uci-f1tenth/Power-board/Tuan Circuit Design LM5155/PCB Design LM5155 Boost Converter.kicad_pcb

## KiCad design Tuan Circuit Design LM5155/PCB Design LM5155 Boost Converter.kicad_pcb (2026-05-14)

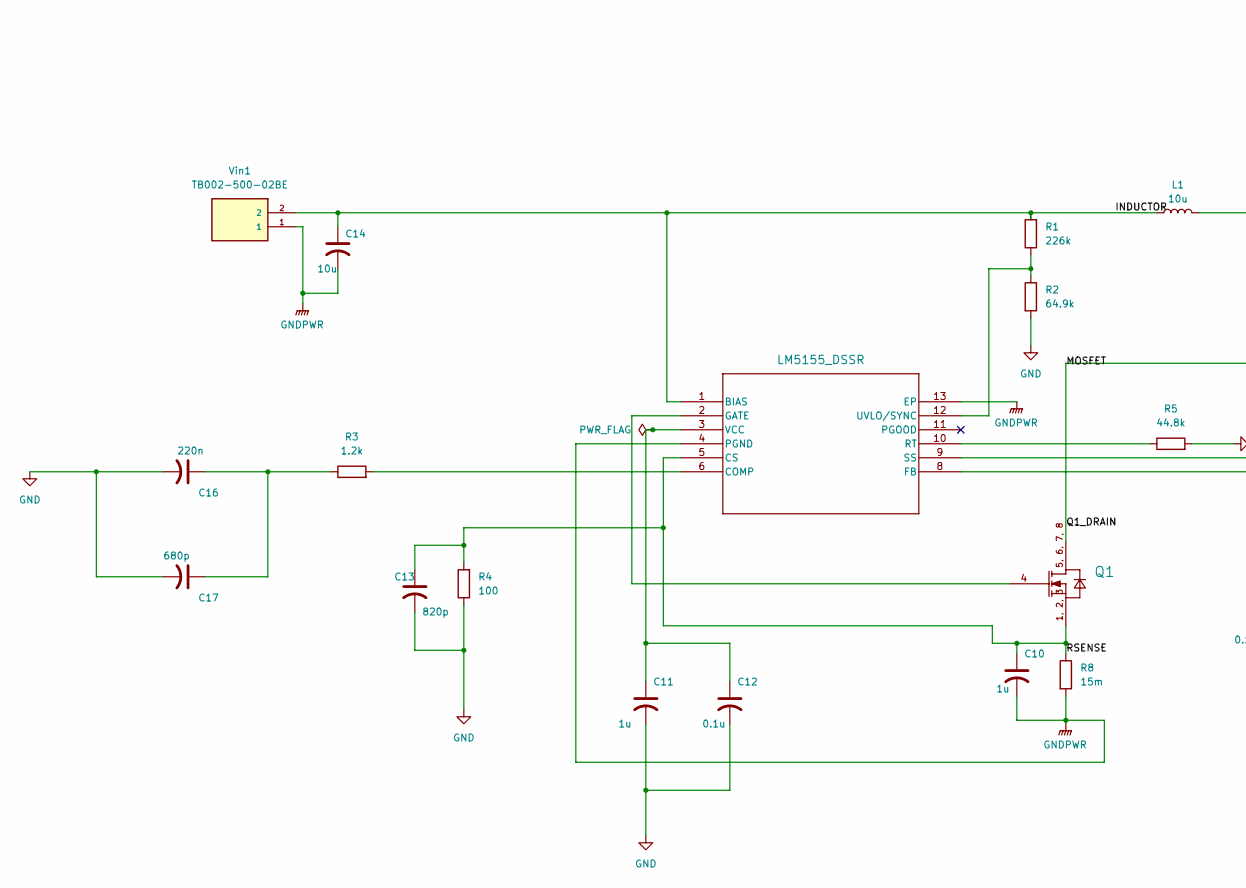
[picture p1: schematic PCB Design LM5155 Boost Converter.kicad_sch, Ai SpiderBot Power System, part in row 1, column 1]

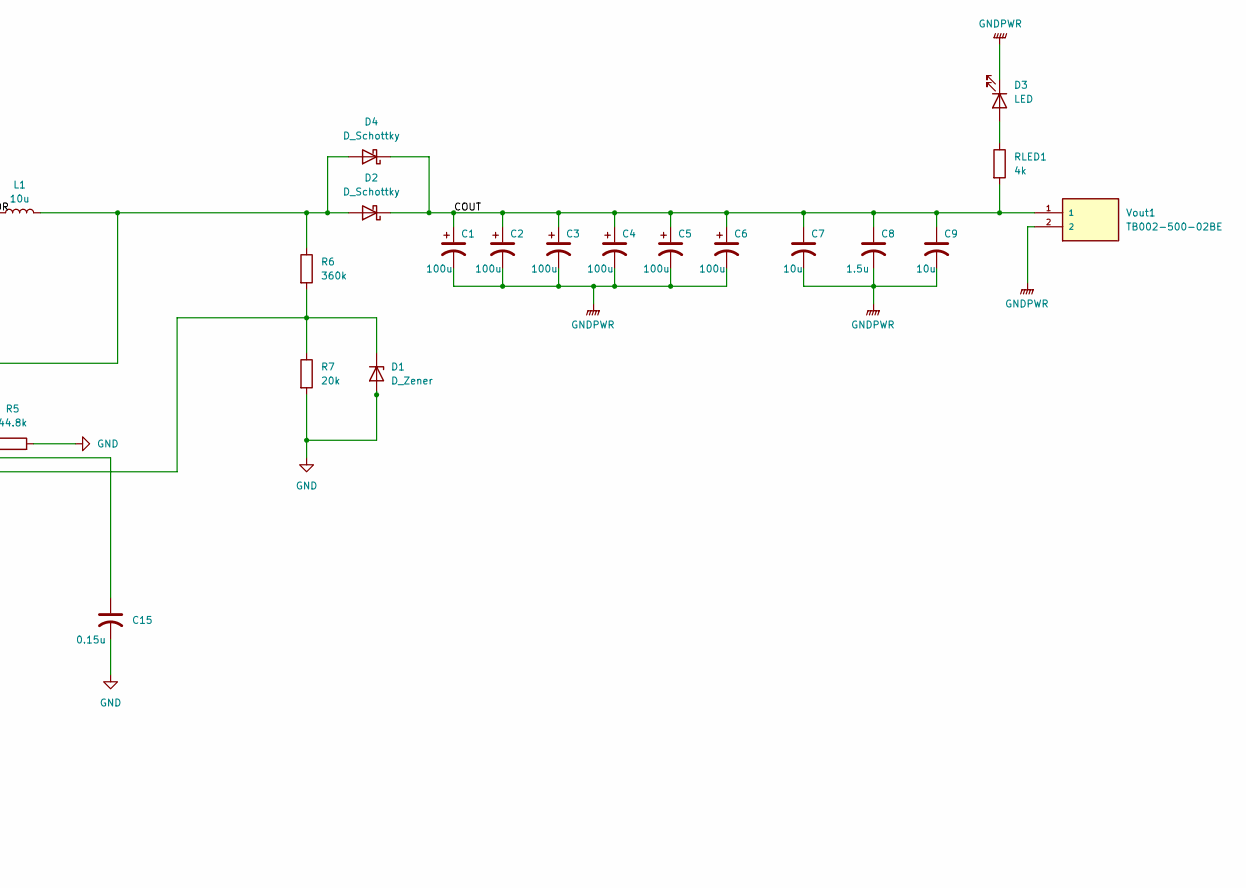
[picture p2: schematic PCB Design LM5155 Boost Converter.kicad_sch, Ai SpiderBot Power System, part in row 1, column 2]

Parts:
C1, C2, C3, C4, C5, C6: 100u; CP_Elec_6.3x5.8
C7, C9, C14: 10u; C_0603_1608Metric
C8: 1.5u; C_0603_1608Metric
C10, C11: 1u; C_0402_1005Metric
C12: 0.1u; C_0603_1608Metric
C13: 820p; C_0402_1005Metric_Pad0.74x0.62mm_HandSolder
C15: 0.15u; C_0603_1608Metric
C16: 220n; C_0603_1608Metric
C17: 680p; C_0603_1608Metric
D1: D_Zener; D_SOD-123
D2, D4: D_Schottky; TO-252-2_TabPin1
D3: LED; LED_0805_2012Metric_Pad1.15x1.40mm_HandSolder
L1: 10u; L_Vishay_IHLP-5050
Q1: BSC035N04LS G; INF-PG-TDSON-8; ManufacturerPartNumber BSC035N04LS G
R1: 226k; R_0603_1608Metric_Pad0.98x0.95mm_HandSolder
R2: 64.9k; R_0603_1608Metric_Pad0.98x0.95mm_HandSolder
R3: 1.2k; R_0603_1608Metric
R4: 100; R_0603_1608Metric_Pad0.98x0.95mm_HandSolder
R5: 44.8k; R_0603_1608Metric_Pad0.98x0.95mm_HandSolder
R6: 360k; R_0402_1005Metric_Pad0.72x0.64mm_HandSolder
R7: 20k; R_0402_1005Metric_Pad0.72x0.64mm_HandSolder
R8: 15m; R_2512_6332Metric_Pad1.40x3.35mm_HandSolder
RLED1: 4k; R_0402_1005Metric_Pad0.72x0.64mm_HandSolder
U1: LM5155_DSSR; WSON_551DSSR_TEX
Vin1: TB002-500-02BE; CUI_TB002-500-02BE
Vout1: TB002-500-02BE; CUI_TB002-500-02BE

Connections:
/COUT: C1.1, C2.1, C3.1, C4.1, C5.1, C6.1, C7.1, C8.1, C9.1, D2.1 (K), D4.1 (K), RLED1.2, Vout1.1
/INDUCTOR: C14.1, L1.1, R1.2, U1.1 (BIAS), Vin1.2
/MOSFET: D2.2 (A), D4.2 (A), L1.2, Q1.5 (DRAIN), Q1.6 (DRAIN), Q1.7 (DRAIN), Q1.8 (DRAIN), R6.1
/RSENSE: C10.1, C13.1, Q1.1 (SOURCE), Q1.2 (SOURCE), Q1.3 (SOURCE), R4.2, R8.1, U1.5 (CS)
GND: C11.2, C12.2, C13.2, C15.2, C16.2, C17.2, D1.2 (A), R2.2, R4.1, R5.2, R7.2
GNDPWR: C1.2, C2.2, C3.2, C4.2, C5.2, C6.2, C7.2, C8.2, C9.2, C10.2, C14.2, D3.1 (K), R8.2, U1.4 (PGND), U1.13 (EP), Vin1.1, Vout1.2
unnamed: C16.1, C17.1, R3.1
unnamed: D1.1 (K), R6.2, R7.1, U1.8 (FB)
unnamed: D3.2 (A), RLED1.1
unnamed: Q1.4 (GATE), U1.2 (GATE)
unnamed: R3.2, U1.6 (COMP)
unnamed: R5.1, U1.10 (RT)
unnamed: C15.1, U1.9 (SS)
unnamed: R1.1, R2.1, U1.12 (UVLO/SYNC)
unnamed: C11.1, C12.1, U1.3 (VCC)

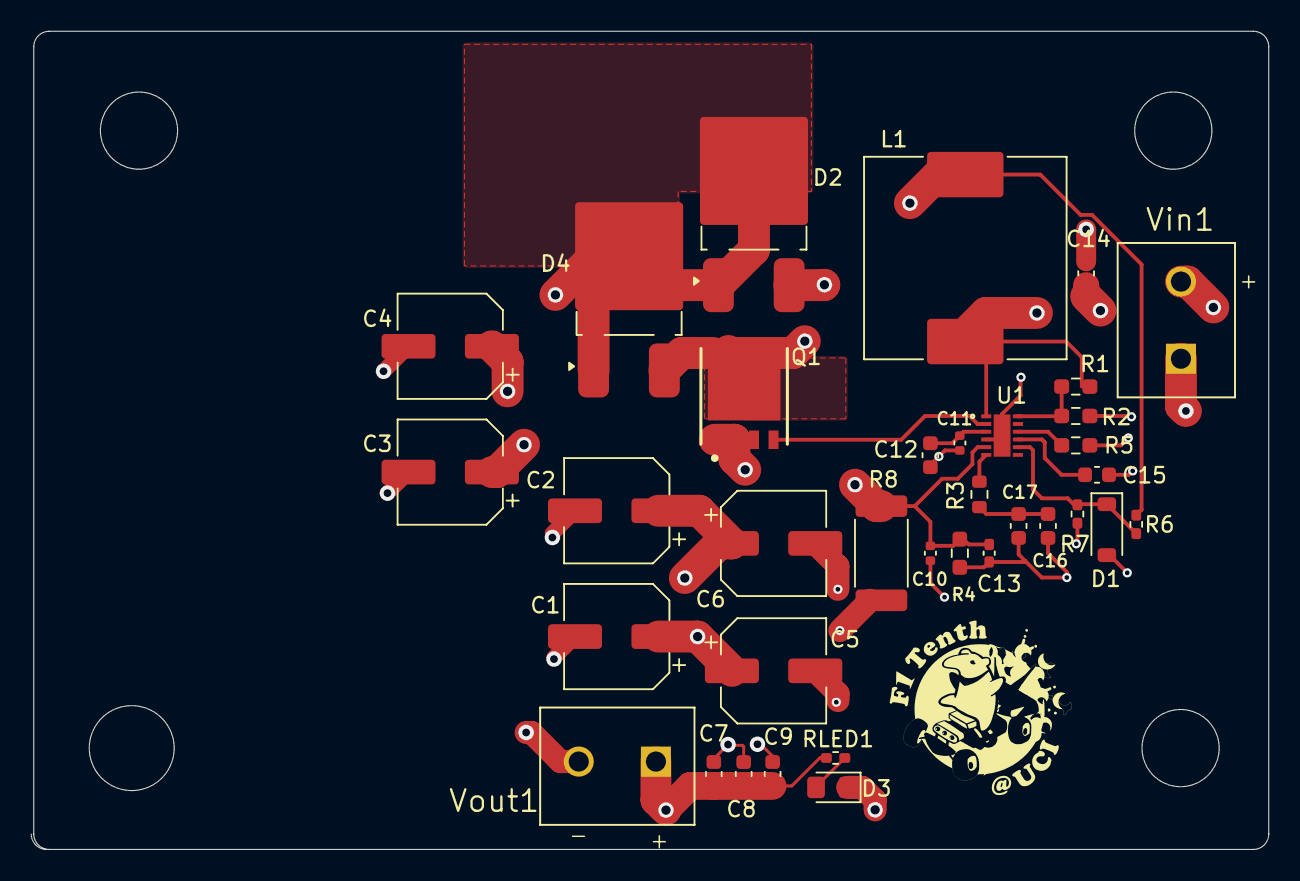
[picture p3: board Tuan Circuit Design LM5155/PCB Design LM5155 Boost Converter.kicad_pcb from above]

Board: 4 copper layers, 80.0 x 53.0 mm, 36 parts (0 on the bottom side), 15 nets.

Other parts of the board:
Ref: LOGO; F1TenthUCILogo
