uci-f1tenth/Power-board/power_board/PCB Design LM5155 Boost Converter.kicad_pcb

## KiCad design power_board/PCB Design LM5155 Boost Converter.kicad_pcb (2026-05-14, an earlier design)

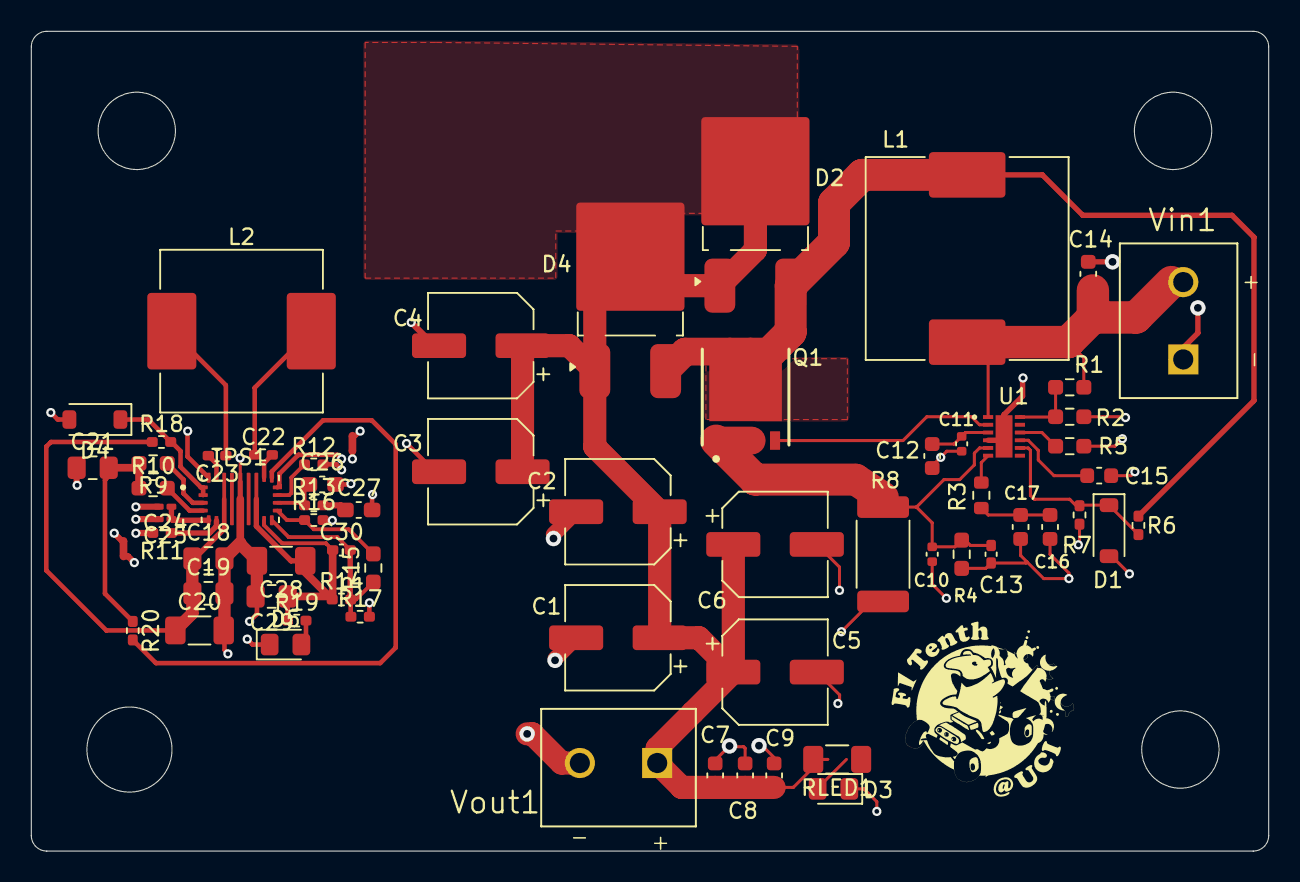
[picture p4: board power_board/PCB Design LM5155 Boost Converter.kicad_pcb from above]

Board: 4 copper layers, 80.0 x 53.0 mm, 67 parts (0 on the bottom side), 34 nets.

Parts:
C1, C2, C3, C4, C5, C6: 100u; CP_Elec_6.3x5.8
C7, C9, C14: 10u; C_0603_1608Metric
C8: 1.5u; C_0603_1608Metric
C10, C11: 1u; C_0402_1005Metric
C12: 0.1u; C_0603_1608Metric
C13: 820p; C_0402_1005Metric_Pad0.74x0.62mm_HandSolder
C15: 0.15u; C_0603_1608Metric
C16: 220n; C_0603_1608Metric
C17: 680p; C_0603_1608Metric
C18, C19: 10u; C_0805_2012Metric_Pad1.18x1.45mm_HandSolder
C20, C28: 22u; C_1206_3216Metric_Pad1.33x1.80mm_HandSolder
C21: 4.7u; C_0805_2012Metric_Pad1.18x1.45mm_HandSolder
C22, C23, C30: 0.1u; C_0402_1005Metric_Pad0.74x0.62mm_HandSolder
C24: 470p; C_0201_0603Metric_Pad0.64x0.40mm_HandSolder
C25: 6.8nF; C_0201_0603Metric_Pad0.64x0.40mm_HandSolder
C26: 100p; C_0603_1608Metric_Pad1.08x0.95mm_HandSolder
C27: 4.7n; C_0603_1608Metric_Pad1.08x0.95mm_HandSolder
C29: 47u; C_0805_2012Metric_Pad1.18x1.45mm_HandSolder
D1: D_Zener; D_SOD-123
D2, D4#2: D_Schottky; TO-252-2_TabPin1
D3, D5: LED; LED_0805_2012Metric_Pad1.15x1.40mm_HandSolder
D4: 3.3; D_SOD-123
L1: 10u; L_Vishay_IHLP-5050
L2: 4.7u; L_Vishay_IHLP-4040
NT1, NT2: NetTie_2; NetTie-2_SMD_Pad0.5mm
Q1: BSC035N04LS G; INF-PG-TDSON-8
R1: 226k; R_0603_1608Metric_Pad0.98x0.95mm_HandSolder
R2: 64.9k; R_0603_1608Metric_Pad0.98x0.95mm_HandSolder
R3: 1.2k; R_0603_1608Metric
R4: 100; R_0603_1608Metric_Pad0.98x0.95mm_HandSolder
R5: 44.8k; R_0603_1608Metric_Pad0.98x0.95mm_HandSolder
R6: 360k; R_0402_1005Metric_Pad0.72x0.64mm_HandSolder
R7: 20k; R_0402_1005Metric_Pad0.72x0.64mm_HandSolder
R8: 15m; R_2512_6332Metric_Pad1.40x3.35mm_HandSolder
R9, R10, R15: 100k; R_0603_1608Metric_Pad0.98x0.95mm_HandSolder
R11: 50k; R_0402_1005Metric_Pad0.72x0.64mm_HandSolder
R12: 150k; R_0402_1005Metric_Pad0.72x0.64mm_HandSolder
R13: 10k; R_0402_1005Metric_Pad0.72x0.64mm_HandSolder
R14: 10m; R_0402_1005Metric_Pad0.72x0.64mm_HandSolder
R16: 11k; R_0402_1005Metric_Pad0.72x0.64mm_HandSolder
R17: 3; R_0402_1005Metric_Pad0.72x0.64mm_HandSolder
R18: 3.3k; R_0402_1005Metric_Pad0.72x0.64mm_HandSolder
R19: 1k; R_0402_1005Metric_Pad0.72x0.64mm_HandSolder
R20: 0; R_0402_1005Metric_Pad0.72x0.64mm_HandSolder
RLED1: 860; R_1206_3216Metric_Pad1.30x1.75mm_HandSolder
Ref: LOGO; F1TenthUCILogo
TPS1: CONV_TPS552892RYQR
U1: LM5155_DSSR; WSON_551DSSR_TEX
Vin1: TB002-500-02BE; CUI_TB002-500-02BE
Vout1: TB002-500-02BE; CUI_TB002-500-02BE

Connections:
/COUT: C1.1, C2.1, C3.1, C4.1, C5.1, C6.1, C7.1, C8.1, C9.1, C18.1, C19.1, C20.1, D2.1 (K), D4#2.1 (K), R18.1, RLED1.2, TPS1.7 (VIN), Vout1.1
/INDUCTOR: D2.2 (A), L1.2, Q1.5 (DRAIN), Q1.6 (DRAIN), Q1.7 (DRAIN), Q1.8 (DRAIN), R6.1
/RSENSE: C10.1, C13.1, Q1.1 (SOURCE), Q1.2 (SOURCE), Q1.3 (SOURCE), R4.2, R8.1, U1.5 (CS)
/VOUT: C28.1, C29.1, C30.1, R14.1, R19.1, TPS1.11 (VOUT), TPS1.12 (ISP)
AGND: C21.1, C24.2, C25.2, C26.2, C27.2, NT1.1, NT2.1, R11.2, R12.2, R16.2, R17.2, TPS1.17 (AGND), TPS1.21 (EXTVCC)
GND: C1.2, C2.2, C3.2, C4.2, C5.2, C6.2, C7.2, C8.2, C9.2, C10.2, C11.2, C12.2, C13.2, C14.2, C15.2, C16.2, C17.2, C18.2, C28.2, C29.2, D1.2 (A), D3.1 (K), D4.2 (A), D5.1 (K), NT1.2, NT2.2, R2.2, R4.1, R5.2, R7.2, R8.2, U1.4 (PGND), U1.13 (EP), Vin1.1, Vout1.2
unnamed: C16.1, C17.1, R3.1
unnamed: C21.2, R20.1
unnamed: C27.1, R13.2
unnamed: D1.1 (K), R6.2, R7.1, U1.8 (FB)
unnamed: D3.2 (A), RLED1.1
unnamed: D4.1 (K), R18.2, TPS1.1 (EN), TPS1.2 (MODE)
unnamed: D5.2 (A), R19.2
unnamed: Q1.4 (GATE), U1.2 (GATE)
unnamed: C23.2, TPS1.20 (BOOT1)
unnamed: C22.2, TPS1.19 (BOOT2)
unnamed: R10.2, TPS1.4 (CC)
unnamed: R12.1, TPS1.16 (CDC)
unnamed: C26.1, R13.1, TPS1.15 (COMP)
unnamed: C24.1, C25.1, TPS1.5 (DITH)
unnamed: R15.2, R16.1, TPS1.14 (FB)
unnamed: R11.1, TPS1.6 (FSW)
unnamed: C30.2, R14.2, R15.1, R17.1, TPS1.13 (ISN)
unnamed: R9.1, TPS1.3 (PG)
unnamed: C23.1, L2.1, TPS1.8 (SW1)
unnamed: C22.1, L2.2, TPS1.10 (SW2)
unnamed: R9.2, R10.1, R20.2, TPS1.18 (VCC)
unnamed: C14.1, L1.1, R1.2, U1.1 (BIAS), Vin1.2
unnamed: R3.2, U1.6 (COMP)
unnamed: R5.1, U1.10 (RT)
unnamed: C15.1, U1.9 (SS)
unnamed: R1.1, R2.1, U1.12 (UVLO/SYNC)
unnamed: C11.1, C12.1, U1.3 (VCC)
PGND: C19.2, C20.2
