uci-f1tenth/Power-board/(commit log)

2025-11-07 current work on redesign
    [powerboard_redesign.kicad_sch]
2025-11-08 redesign re-upload
    evaluation from Bradley would be appreciated
    [powerboard_redesign.kicad_sch]
2025-11-10 newest iteration
    need to add footprints for pcb
    [powerboard_redesign.kicad_sch]
2025-11-10 current directory with PDQ30-Q24-S12-D
    PDQ30-Q24-S12-D footprint added, need to add 1x4 connector for battery and other foot prints, need to figure out two capacitor values
    [PDQ30-Q24-D12-D.step, powerboard_redesign.kicad_pcb, powerboard_redesign.kicad_sch]
2026-01-06 Version One Done
    still need to resize some traces, and fix some overlaps stated in KiCAD DRC
    [100SP1T1B4M2QE.step, 282834-2.step, PDQ30-Q24-D12-D.step, powerboard_redesign.kicad_pcb, powerboard_redesign.kicad_sch]
2026-01-08 Traces fixed
    Ready for print on Version One
    [100SP1T1B4M2QE.step, 282834-2.step, PDQ30-Q24-D12-D.step, powerboard_redesign.kicad_pcb, powerboard_redesign.kicad_sch]
2026-01-08 Gerber and Excellon Files
    Added the Gerber and Excellon Files and a file with the bill of materials and pick and place files (CPL, I think).
    [powerboard_redesign.csv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]
2026-01-15 updated bom for digikey
    [powerboard_redesign.csv]
2026-02-12 Updated V2 Powerboard
    Fixed some connections, check if correct, still need to add some features for redundancy and safety
    [100SP1T1B4M2QE.step, 282834-2.step, PDQ30-Q24-D12-D.step, bom.csv, designators.csv, positions.csv, powerboard_redesign.kicad_pcb, powerboard_redesign.kicad_sch]
2026-03-29 Added Project Specific Library configs for Footprints and Symbols
2026-03-29 Added BM06B-SRSS-TB Connector
    For powering LiDAR module, reference: https://github.com/AlistairKeiller/Lidar-Power-Adapter
2026-03-29 Added BM06B-SRSS-TB to Schematic
    No wires yet, need to know LiDAR module pins
    [powerboard_redesign.kicad_sch]
2026-03-31 Adjusted other parts to use Project Specific Library Paths
    [powerboard_redesign.kicad_sch]
2026-03-31 Added Datasheet link for BM06-SRSS-TB Connector
    [powerboard_redesign.kicad_sch]
2026-04-02 Added connections to BM06B-SRSS-TB
    [powerboard_redesign.kicad_sch]
2026-04-02 Added Footprint and Symbol files for Battery Connector
    [B4B-XH-A.step]
2026-04-02 Added B4B-XH-A (Battery) Connector to Project Specific Library
2026-04-02 Added 3D Step file to Battery Connector Footprint
2026-04-02 Added Step file for BM06B-SRSS-TB Connector
    [BM06B-SRSS-TB.STEP]
2026-04-02 Added Step file to BM06B-SRSS-TB Footprint
2026-04-02 Replaced Screw Terminal with B4B-XH-A for Battery
    [powerboard_redesign.kicad_sch]
2026-04-02 Updated PCB with new connectors
    [powerboard_redesign.kicad_pcb]
2026-04-09 Updated schematic and PCB for V3
    Added 4-pin connector for LiDAR connector
    [powerboard_redesign.kicad_pcb, powerboard_redesign.kicad_sch]
2026-04-09 Powerboard V3 Files
    [bom-JLCPCB Assembly Order.xls, bom.csv, designators.csv, positions.csv]
2026-04-23 Replaced D12 Buck Converter with S12 Buck Converter
    Great Job Allen!
    [PDQ30-Q24-D12-D.step, PDQ30-Q24-S12-D.step]
2026-04-23 Updated Powerboard to have S12 instead of D12 + Added 2 Terminal Block on Battery Side
    [powerboard_redesign.kicad_sch]
2026-04-23 Updated PCB with S12 Buck Converter + extra screw terminal block on Battery side
    [powerboard_redesign.kicad_pcb]
2026-04-24 Added 28 awg terminal block for LiDAR
2026-04-24 Added 28 awg terminal block to schematic
    This is for LiDAR connection power wires as another option instead of JST 6-pin connector
    [powerboard_redesign.kicad_sch]
2026-04-24 Updated 28 awg block with 3D model
    [CONN_SD-39357-001_02P_MOL.stp, powerboard_redesign.kicad_pcb]
2026-04-24 Added .gitignore for KiCAD temporary files
2026-05-10 Version 5
    Initial Commit
    [100SP1T1B4M2QE.step, 282834-2.step, B4B-XH-A.step, BM06B-SRSS-TB.STEP, CONN_SD-39357-001_02P_MOL.stp, PCB Design LM5155 Boost Converter.kicad_pcb, PCB Design LM5155 Boost Converter.kicad_sch, PDQ30-Q24-S12-D.step]
2026-05-10 Updated the LIDAR Power Supply
    [PCB Design LM5155 Boost Converter.kicad_sch]
2026-05-10 Completed Schematic for LIDAR Power
    [PCB Design LM5155 Boost Converter.kicad_sch]
2026-05-11 Updated PCB Schematic
    Moved the LM5155 to the right
    [PCB Design LM5155 Boost Converter.kicad_pcb, PCB Design LM5155 Boost Converter.kicad_sch]
2026-05-13 Routing for TPS Module
    [PCB Design LM5155 Boost Converter.kicad_pcb, PCB Design LM5155 Boost Converter.kicad_sch]
2026-05-14 PCB Traces
    [PCB Design LM5155 Boost Converter.kicad_pcb, PCB Design LM5155 Boost Converter.kicad_sch]
2026-05-14 added box
    [PCB Design LM5155 Boost Converter.kicad_pcb]
2026-05-14 Added circle
    [PCB Design LM5155 Boost Converter.kicad_pcb]
2026-05-14 2 Layer to 4 Layer PCB
    [PCB Design LM5155 Boost Converter.kicad_pcb]
2026-05-14 Updated Schematic
    [PCB Design LM5155 Boost Converter.kicad_sch]
2026-05-14 Upload file for my own branch
    [PCB Design LM5155 Boost Converter.kicad_pcb, PCB Design LM5155 Boost Converter.kicad_sch]
2026-05-14 Circuit after fix with 4 layer PCB
    [PCB Design LM5155 Boost Converter.kicad_pcb, PCB Design LM5155 Boost Converter.kicad_sch]
